wildlifesense/WSTL18/README.md

This repository was moved to https://github.com/NikosVallianos/NestProbe-TL1 due to project renaming and restructuring.
