wildlifesense/WSTL18/Eagle/WSTL18P2_PLUS/WSTL18P2.brd

## EAGLE design Eagle/WSTL18P2_PLUS/WSTL18P2.brd (2018-02-20)

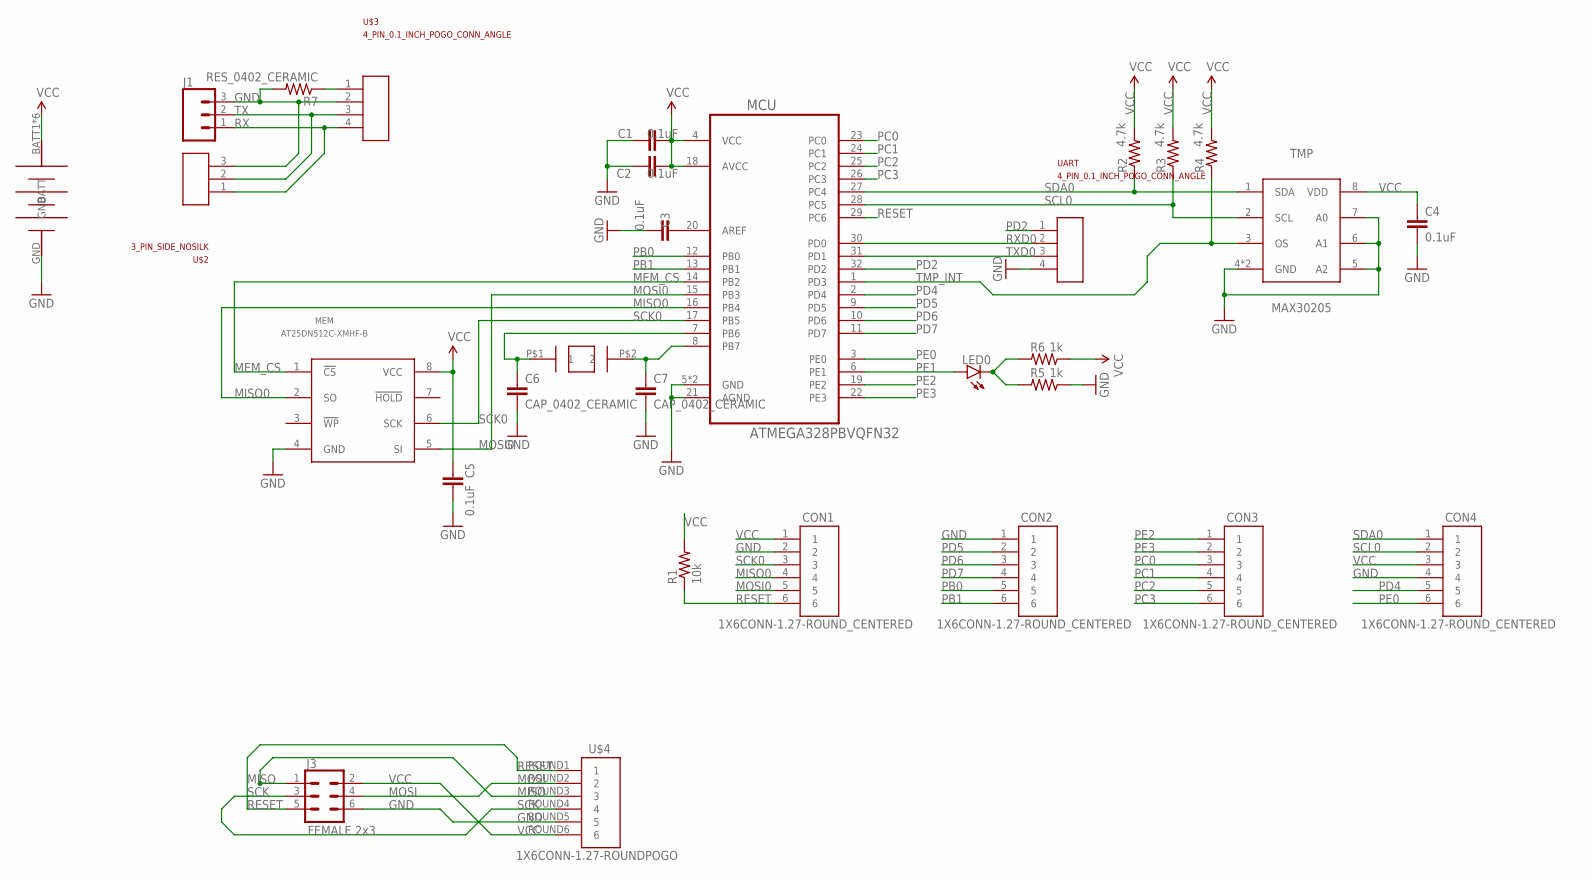
[picture p1: schematic WSTL18P2.sch]

Parts:
C1, C2, C3: 0.1uF; SMD_0402
C4, C5: 0.1uF; CAP_0402
C6, C7: CAP_0402_CERAMIC; CAP_0402
CON1, CON2, CON3, CON4: 1X6CONN-1.27-ROUND_CENTERED; 1X6_1.27_ROUND_CENTERED
J1: CONN_03; 1X03
J3: FEMALE 2x3; 2X3
LED0: LED_0402
MCU: ATMEGA328PBVQFN32; ATMEGA328PB_VFQFN32
MEM: AT25DN512C-XMHF-B; TSSSOP-8
R1: 10k; RES_0402
R2, R3, R4: 4.7k; RES_0402
R5, R6: 1k; RES_0402
R7: RES_0402_CERAMIC; RES_0402
T1: ABS07AIG
TMP: MAX30205; MAX30205_TDFN8
U$1: LINX-CR2032-BAT-HLD-M-THM; CR2032-LINX-M-THM
U$2: 3_PIN_SIDE_NOSILK; 3PIN_SIDE_0.1_INCH_NOSILK
U$3: 4_PIN_0.1_INCH_POGO_CONN_ANGLE; 4_PIN_0.1INCH_POGO_PADS_ANGLE
U$4: 1X6CONN-1.27-ROUNDPOGO; 1X6_1.27_SIDEPOGO
UART: 4_PIN_0.1_INCH_POGO_CONN_ANGLE; 4_PIN_0.1INCH_POGO_PADS_ANGLE

Connections:
AREF: C3.1, MCU.20 (AREF)
GND: C1.2, C2.2, C3.2, C4.2, C5.2, C6.2, C7.2, CON1.2, CON2.1, CON4.4, J1.3, J3.6, MCU.5 (GND), MCU.21 (AGND), MCU.PAD (GND), MEM.4 (GND), R5.2, R7.1, TMP.4 (GND), TMP.5 (A2), TMP.6 (A1), TMP.7 (A0), TMP.PAD (GND), U$1.GND, U$2.3, U$3.2, U$4.ROUND5 (5), UART.4
INT0: R7.2, U$3.1
MEM_CS: MCU.14 (PB2), MEM.1 (!CS!)
MISO: J3.1, U$4.ROUND3 (3)
MISO0: CON1.4, MCU.16 (PB4), MEM.2 (SO)
MOSI: J3.4, U$4.ROUND2 (2)
MOSI0: CON1.5, MCU.15 (PB3), MEM.5 (SI)
unnamed: C7.1, MCU.8 (PB7), T1.P$2 (2)
unnamed: C6.1, MCU.7 (PB6), T1.P$1 (1)
unnamed: LED0.CATHODE (C), R5.1, R6.1
PB0: CON2.5, MCU.12 (PB0)
PB1: CON2.6, MCU.13 (PB1)
PC0: CON3.3, MCU.23 (PC0)
PC1: CON3.4, MCU.24 (PC1)
PC2: CON3.5, MCU.25 (PC2)
PC3: CON3.6, MCU.26 (PC3)
PD2: MCU.32 (PD2), UART.1
PD4: CON4.5, MCU.2 (PD4)
PD5: CON2.2, MCU.9 (PD5)
PD6: CON2.3, MCU.10 (PD6)
PD7: CON2.4, MCU.11 (PD7)
PE0: CON4.6, MCU.3 (PE0)
PE1: LED0.ANODE (A), MCU.6 (PE1)
PE2: CON3.1, MCU.19 (PE2)
PE3: CON3.2, MCU.22 (PE3)
RESET: CON1.6, J3.5, MCU.29 (PC6), R1.2, U$4.ROUND1 (1)
RX: J1.1, U$2.1, U$3.4
RXD0: MCU.30 (PD0), UART.2
SCK: J3.3, U$4.ROUND4 (4)
SCK0: CON1.3, MCU.17 (PB5), MEM.6 (SCK)
SCL0: CON4.2, MCU.28 (PC5), R3.2, TMP.2 (SCL)
SDA0: CON4.1, MCU.27 (PC4), R2.2, TMP.1 (SDA)
TMP_INT: MCU.1 (PD3), R4.2, TMP.3 (OS)
TX: J1.2, U$2.2, U$3.3
TXD0: MCU.31 (PD1), UART.3
VCC: C1.1, C2.1, C4.1, C5.1, CON1.1, CON4.3, J3.2, MCU.4 (VCC), MCU.18 (AVCC), MEM.8 (VCC), R1.1, R2.1, R3.1, R4.1, R6.2, TMP.8 (VDD), U$1.BATT1 (BATT), U$1.BATT2 (BATT), U$1.BATT3 (BATT), U$1.BATT4 (BATT), U$1.BATT5 (BATT), U$1.BATT6 (BATT), U$4.ROUND6 (6)

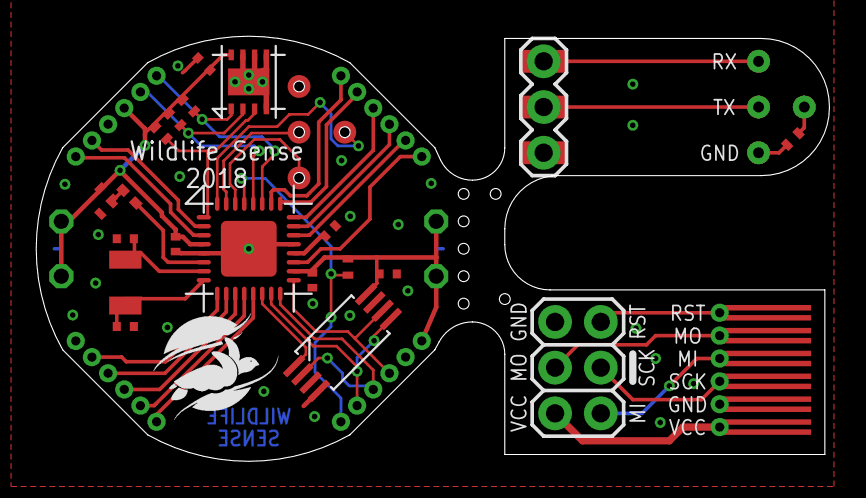
[picture p2: board WSTL18P2.brd from above]

Board: 2 copper layers, 44.1 x 23.6 mm, 30 parts (1 on the bottom side), 37 nets.
