wildlifesense/WSTL18/Eagle/WSTL18_ISP/WSTL18_ISP.brd

## EAGLE design Eagle/WSTL18_ISP/WSTL18_ISP.brd (2018-01-13)

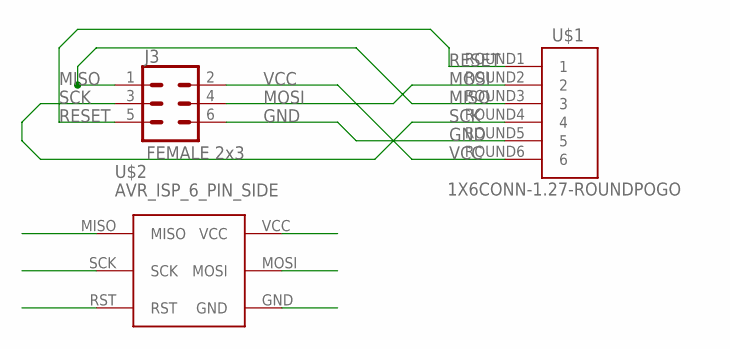
[picture p3: schematic WSTL18_ISP.sch]

Parts:
J3: FEMALE 2x3; 2X3
U$1: 1X6CONN-1.27-ROUNDPOGO; 1X6_1.27_SIDEPOGO
U$2: AVR_ISP_6_PIN_SIDE; AVR_ISP_SIDE_0.1_INCH

Connections:
GND: J3.6, U$1.ROUND5 (5), U$2.GND
MISO: J3.1, U$1.ROUND3 (3), U$2.MISO
MOSI: J3.4, U$1.ROUND2 (2), U$2.MOSI
RESET: J3.5, U$1.ROUND1 (1), U$2.RST
SCK: J3.3, U$1.ROUND4 (4), U$2.SCK
VCC: J3.2, U$1.ROUND6 (6), U$2.VCC

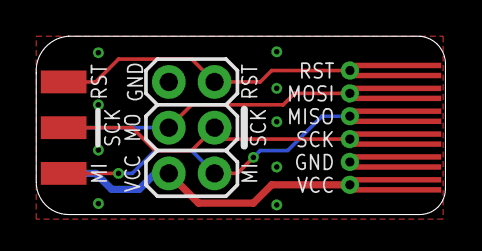
[picture p4: board WSTL18_ISP.brd from above]

Board: 2 copper layers, 22.7 x 9.9 mm, 3 parts (0 on the bottom side), 6 nets.
