wildlifesense/WSTL18/Eagle/WSTL18_SHIELD/WSTL18P2_SHIELD.brd

## EAGLE design Eagle/WSTL18_SHIELD/WSTL18P2_SHIELD.brd (2018-01-08)

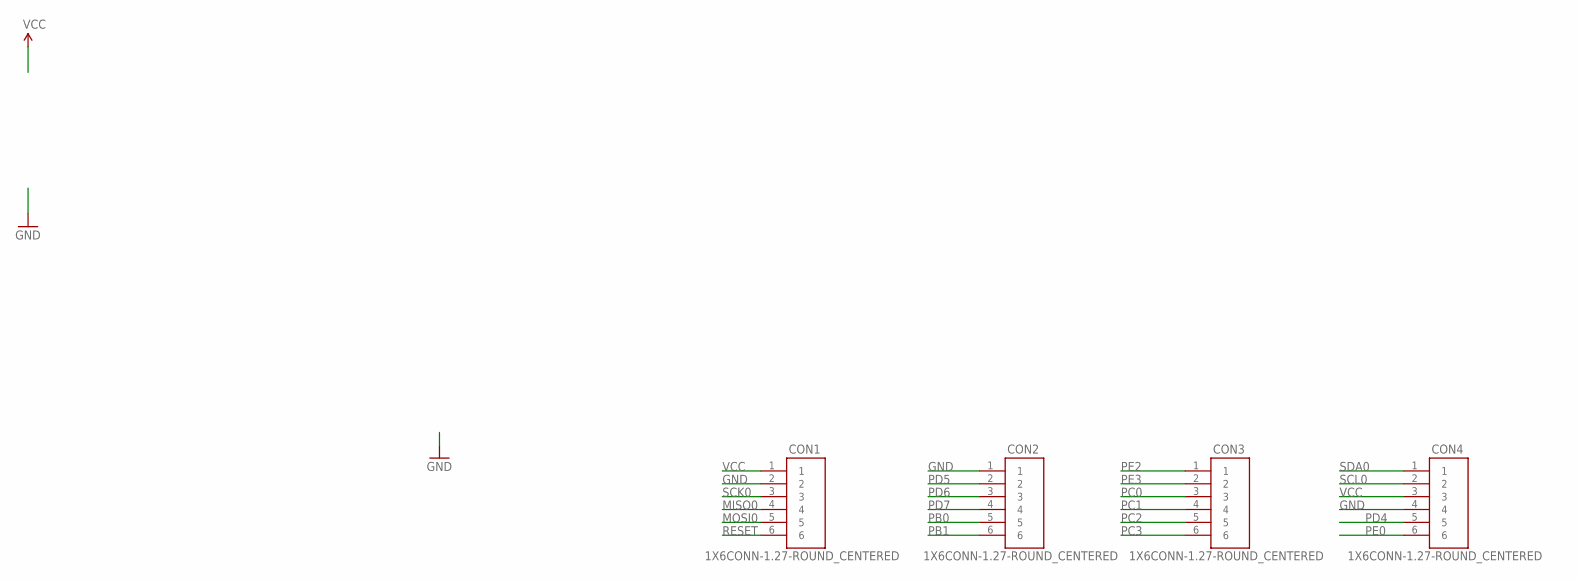
[picture p5: schematic WSTL18P2_SHIELD.sch]

Parts:
CON1, CON2, CON3, CON4: 1X6CONN-1.27-ROUND_CENTERED; 1X6_1.27_ROUND_CENTERED

Connections:
GND: CON1.2, CON2.1, CON4.4
MISO0: CON1.4
MOSI0: CON1.5
PB0: CON2.5
PB1: CON2.6
PC0: CON3.3
PC1: CON3.4
PC2: CON3.5
PC3: CON3.6
PD4: CON4.5
PD5: CON2.2
PD6: CON2.3
PD7: CON2.4
PE0: CON4.6
PE2: CON3.1
PE3: CON3.2
RESET: CON1.6
SCK0: CON1.3
SCL0: CON4.2
SDA0: CON4.1
VCC: CON1.1, CON4.3

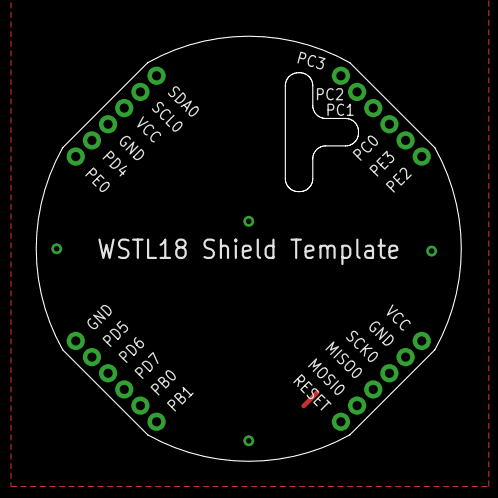
[picture p6: board WSTL18P2_SHIELD.brd from above]

Board: 2 copper layers, 23.6 x 23.6 mm, 4 parts (0 on the bottom side), 2 nets.
