wildlifesense/WSTL18/(commit log)

2017-12-23 Added led module
2017-12-23 Added spi, twi, uart, and wstl18 modules
2017-12-24 Added dia flow diagram files (dia and pdf)
2017-12-24 Added eagle design files
    [WSTL18P1.brd, WSTL18P1.sch, WSTL18P2.brd, WSTL18P2.sch]
2017-12-24 Renamed EAGLE folder into Eagle
    [WSTL18P1.brd, WSTL18P1.sch, WSTL18P2.brd, WSTL18P2.sch]
2017-12-24 Adding 1.27mm headers to TWI (I2C) lines.
    This will make the TWI accessible to expansion shields.
    [WSTL18P2.brd, WSTL18P2.sch]
2017-12-24 Reducing signal trace widths towards 6mil
    [WSTL18P2.brd, WSTL18P2.sch]
2017-12-24 Changing signal traces to 6 mil
    [WSTL18P2.brd, WSTL18P2.sch]
2017-12-25 More routing optimizations and changing trances to 6 mil.
    [WSTL18P2.brd, WSTL18P2.sch]
2017-12-26 Added a battery module
2017-12-26 Removed battery module. Will add when core function done
2017-12-30 Making TWI (I2C) pins available on perimeter headers
    [WSTL18P2.brd, WSTL18P2.sch]
2018-01-02 Made TWI (I2C) available on perimeter 1.27mm headers
    [WSTL18P2.brd, WSTL18P2.sch]
2018-01-03 More work on TWI (I2C) traces
    [WSTL18P2.brd]
2018-01-03 Work on the memory functions to record a temperature log
2018-01-03 Added pads on the positive battery holder contacts
    This will allow use of both SMD and through-hole versions of the battery holder
    [WSTL18P2.brd, WSTL18P2.sch]
2018-01-03 Moved battery GND pad to a sincle circular in centre
    [WSTL18P2.brd, WSTL18P2.sch]
2018-01-03 Reverted some passives back to 0402 size
    [WSTL18P2.brd, WSTL18P2.sch]
2018-01-03 Removed WP and HOLD connections to VCC on EEPROM
    Chip has internal pull-ups for when WP and HOLD functions are not used
    [WSTL18P2.brd, WSTL18P2.sch]
2018-01-03 Rerouted TWI (I2C)
    [WSTL18P2.brd, WSTL18P2.sch]
2018-01-04 Eliminated all 0201 passives, changed uart connection pin
    [WSTL18P2.brd, WSTL18P2.sch]
2018-01-04 Chaned LED pin, added VCC and GND next to TWI(I2C) headers, changed some traces to 8mil
    [WSTL18P2.brd, WSTL18P2.sch]
2018-01-05 Changing some traces up to 8 mils where space is available
    [WSTL18P2.brd]
2018-01-05 Final corrections for WSTL18P2
    [WSTL18P2.brd, WSTL18P2.sch]
2018-01-06 Approved and cleared design rules checks
    [WSTL18P2.brd, WSTL18P2.sch]
2018-01-07 Added a couple of notes for power reduction
2018-01-07 Minor port bit reference correction
    [twi.c]
2018-01-07 Corrected to DDR instead of PIN which wouldn't have worked
    [twi.c]
2018-01-07 Added sleep instructions, blinker, and uart functions
2018-01-07 Added ISP connector eagle files
    [WSTL18_ISP.GBL, WSTL18_ISP.GBO, WSTL18_ISP.GBS, WSTL18_ISP.GKO, WSTL18_ISP.GTL, WSTL18_ISP.GTO, WSTL18_ISP.GTP, WSTL18_ISP.GTS]
2018-01-07 Removed gerber files
    [WSTL18_ISP.GBL, WSTL18_ISP.GBO, WSTL18_ISP.GBS, WSTL18_ISP.GKO, WSTL18_ISP.GTL, WSTL18_ISP.GTO, WSTL18_ISP.GTP, WSTL18_ISP.GTS]
2018-01-08 Finished design of WSTL18 in-system programming adaptor
    [WSTL18_ISP.brd, WSTL18_ISP.sch]
2018-01-08 Center-alligned all 4 6-wire headers
    [WSTL18P2.brd, WSTL18P2.sch]
2018-01-08 Added WSTL18 template shield eagle files
    [WSTL18P2_SHIELD.brd, WSTL18P2_SHIELD.sch]
2018-01-09 Debugging for power consumption and operation
2018-01-11 Corrected board title layer
    [WSTL18_ISP.brd]
2018-01-12 Simplifying uart library
2018-01-12 Streamlined the spi module
2018-01-13 Temperature sensor seems to work like this
2018-01-13 Minor modifications
    [WSTL18P2.brd, WSTL18P2.sch]
2018-01-13 Added in-system programming adaptor
    [WSTL18_ISP.brd, WSTL18_ISP.sch]
2018-01-16 Fixed speed-limiting initialization errors
    [uart.c]
2018-01-16 Restructuring TWI module to introduce error checking
    [main.c, twi.c, twi.h]
2018-01-24 Fixed uart disable to allow minor delay
    This is an undocumented issue with seldom reporting in the community:
    If the device goes to sleep righ after something has been sent over uart,
    the AVR's uart buffers get messed up and remain so even when the uart is
    powered off before sleep and then on again after wakeup. The datasheet
    says that the TXC register must be checked, but even when it is the
    buffers still get messed up. The only viable solution was to add a
    25 micro-second delay before disabling the uart interface, to allow
    for the buffers to be cheared. This seems to work and since the time delay
    is pretty small, I don't think I'll try to fix this any further.
    [uart.c, uart.h]
2018-01-24 Fixing TWI STOP bug
    Apparently, when the AVR sets the stop condition on the TWI lines,
    you don't have to wait for the TWINT flag. If you do, you'll never
    get it, which makes the entire program hang. The stop condition
    doesn't affect any buffers, so there's no need to wait. Just set the
    stop condition and leave.
    [twi.c, twi.h]
2018-01-28 Too many fixes to list
    [main.c, max30205.c, max30205.h, memory.c, memory.h, spi.c, spi.h, twi.c]
2018-01-28 Added WSTL18P2 eagle with uart and ISP adaptors
    [WSTL18P2.brd, WSTL18P2.sch]
2018-01-28 Added eagle files for UART adaptor
    [WSTL18_UART.brd, WSTL18_UART.sch]
2018-02-04 Reflects change in local version of Atmel Software Framework
2018-02-04 Reflects local change in Atmel Software Framework
2018-02-07 Removed led.c and led.h
2018-02-20 Removed a couple of diagrams to reorganize them
    [WSTL18P2.brd, WSTL18P2.sch]
2018-02-21 Added an error tracking module
    [error.c, error.h, main.c]
2018-02-21 Consolidating a couple of loose modules into main.c
    [main.c]
